flaviostutz/skylight-uas/media/suav_back.jpg

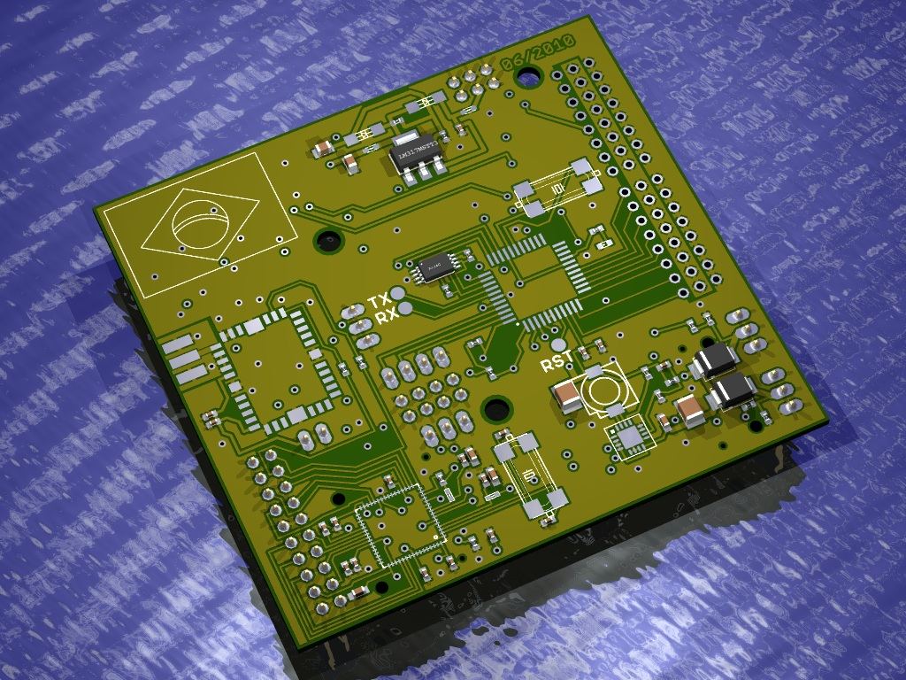
media/suav_back.jpg
