flaviostutz/skylight-uas/media/suav_front2.jpg

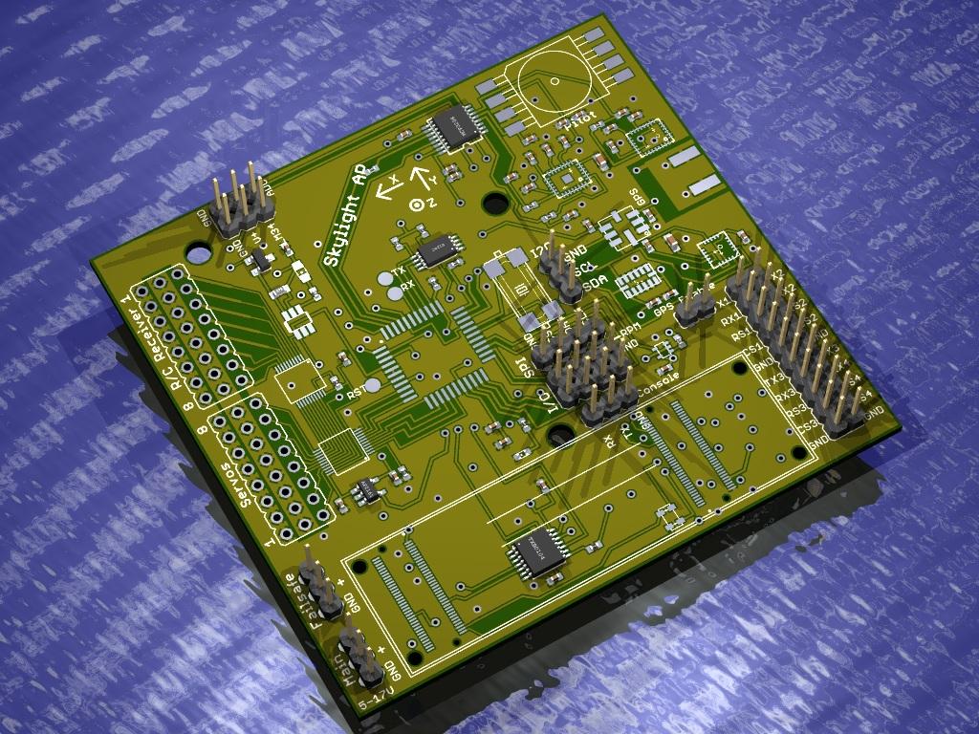
media/suav_front2.jpg
