flaviostutz/skylight-uas/src/skylight-autopilot-simulation/bin/br/skylight/flightsim/cessnamodel/FIN1.JPG

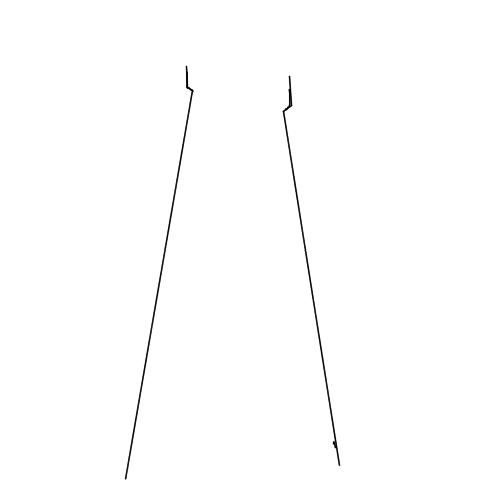
src/skylight-autopilot-simulation/bin/br/skylight/flightsim/cessnamodel/FIN1.JPG
