flaviostutz/skylight-uas/src/skylight-autopilot-simulation/bin/br/skylight/flightsim/cessnamodel/FUS.JPG

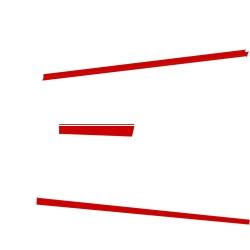
src/skylight-autopilot-simulation/bin/br/skylight/flightsim/cessnamodel/FUS.JPG
