flaviostutz/skylight-uas/src/skylight-autopilot-simulation/bin/br/skylight/flightsim/cessnamodel/WING1.JPG

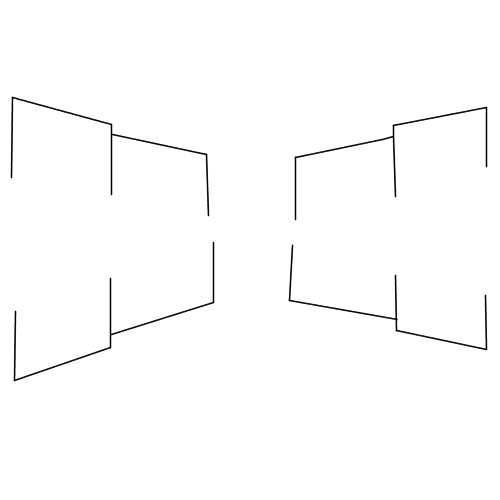
src/skylight-autopilot-simulation/bin/br/skylight/flightsim/cessnamodel/WING1.JPG
