flaviostutz/skylight-uas/src/skylight-cucs/files/Planning.xlsx

Sheet: Overall
Item | Who | Phase | Anotações | Model | Budget (US$)
Video system
Camera |  | Ready to use | Consertar problema de mal contato | Sony FCBEX78BP
2.4GHz omni antenna |  | Ready to use |  | Blackwidow
2.4GHz video transmitter |  | Ready to use |  | Blackwidow | $229.00 | http://www.blackwidowav.com/bwav2401000components.html
2.4GHz patch antenna |  | Ready to use
2.4GHz video receiver |  | Ready to use |  | Blackwidow
Antenna gimbal PT |  | Not planned
Antenna tracking system |  | Not planned | Create PWM signals from serial commands about desired pan/tilt
A/V capture card |  | Ready to use
Camera PTZ system |  | Ready to build | Create PWM signals from serial commands about desired pan/tilt
Camera gimbal PT |  | Ready to build | Testes de vibração, drag etc
Data link system
900MHz Omni antenna 1 |  | Ready to use |  | Aerocomm 4790 kit
900MHz Transceiver 1 |  | Ready to build | Colocar em uma caixa | Aerocomm 4790 kit
900MHz Omni antenna 2 |  | Ready to use |  | Aerocomm 4790 kit
900MHz Transceiver 2 |  | Ready to build | Adaptar ao sistema do avião (conector, alimentação etc) | Aerocomm 4790 kit
Ground Station
Skylight Ground Station |  | Building | Antenna tracking interface, video recording, video assisted mode, bottle drop control Camera control: manual PTZ control, auto track point commands, camera settings (day/night mode, EV level, focus mode)
Video recording software |  | Ready to build
Autopilot system
Skylight autopilot |  | Building | Camera control (IR stabilization, track point, manual commands from ground - PTZ) Bottle launch, manual termination, log storage
Onboard OS |  | Ready to build | Linux distribution, OpenSDK Java 1.6, 1 serial port, 2 USB ports for serial comm, sd card boot/storage
Onboard computer |  | Ready to build | Ajustar montagem em caixa adequada, teste de vibração, interferências, estabilidade de temperatura, montagem da alimentação, conectores de comunicação (serial, USB) | Via PX5000EG | $259.95 | http://www.e-itx.com/via-epia-px5000eg.html
Sensors
GPS |  | Ready to build
Termopiles |  | Ready to use
Pressure sensor |  | Ready to build
Sonar |  | Not planned | Somente com decolagem autônoma
RPM sensor |  | Ready to build
Emergency terminator
Watchdog |  | Ready to build
Parachute launcher |  | Not planned | Ver construção final do lançador
Engine kill system |  | Ready to build
Misc
Bottle launcher |  | Ready to build
Main power system |  | Ready to build
Backup power system |  | Ready to build
Actuators servos |  | Ready to use
2 X USB serial cable (UAV) |  | Ready to use
2 X USB serial cable (Ground) |  | Not planned
2 X optical cable (UAV) |  | Ready to use
SD Micro card 1 GB |  | Planned

Sheet: Tasks software
Criar view de monitoração/configuração de ADT e GDT |  | 2 | Ready to build | X | Marco 6: Validação do sistema de terminação de vôo | Sistemas de terminação prontos e testados
Adaptar Skylight Autopilot para JSE |  | 2 | Ready to use | X
Criar gateway para AC4790 no piloto automático |  | 2 | Ready to build | X | Marco 5: Vôo com vídeo estabilizado | Validação da eficácia do sistema em campo
Criar gateway para AC4790 no VSM | Testar comandos proprietários do modem como leitura de tabela RSSI etc | 2 | Ready to build | X
Escolher distribuição de Linux |  | 2 | Planned | X
Fazer adaptador USB-Serial funcionar no Linux |  | 2 | Planned | X | Marco 2: Simulação com hardware-in-the-loop | Validação do hardware e software montados
Fazer testes de hardware in the loop | Pendente dos itens da fase 2 | 2 | On analysis | X | Marco 3: Vôo com piloto automático no hardware/software novos | Validar plataforma em campo e ajustar piloto automático para um nível de confiabilidade alto
Fazer testes do throttle |  | 2 | Ready to build | X
Montar distribuição linux bootável pronta | Falta verificar | 2 | Ready to build | X
Testar piloto automático no Linux |  | 2 | On analysis | X
Implementar view de controle de waypoint |  | 2 | Ready to build | X
Validar controle de waypoint em simulador |  | 2 | Planned | X
Validar controle de loiter em simulador |  | 2 | Planned | X
Criar view de manutenção de missão | Waypoints, routes, safety actions, boundaries, home, etc | 2 | Ready to build | X
Validar controle de missão no simulador |  | 2 | Planned | X
Fazer failover no piloto automático para perda de sinal de GPS/link principal | Desenhar estratégias de fail-over | 3 | Ready to build |  | Marco 7: Missão de busca simulada em campo | Validação de plataforma e procedimentos da missão adotados
Melhorar logs da caixa preta | Colocar logs de comandos manuais e fases da missão | 3 | Ready to build |  | Marco 4: Vôo com piloto automático + vídeo | Verificar funcionamento correto da plataforma com vídeo ativado e qualidade do sinal
Alterar gateway de atuadores para incluir comandos PTZ da camera |  | 4 | Ready to build
Configurações da camera | day/night mode, EV level, focus mode | 4 | Ready to build
Controle PTZ da camera | Controle de pan/tilt/zoom com joystick. O piloto automático corrigirá o gimbal de acordo com a atitude do avião. | 4 | Ready to build
Criar gateway para camera para enviar comandos de configuração e zoom |  | 4 | Ready to build
Enviar comandos do ground station para a câmera | Levar em conta a estabilização de acordo com atitude | 4 | Ready to build
Fazer mudança nas mensagens com UAV para incluir comandos/configurações relacionadas à imageria | Verificar itens de imageria | 4 | Ready to build
Gravador de vídeo | Placa de captura | 4 | Ready to build
Snapshot do vídeo a partir do joystick | Histórico georeferenciado de fotos, com opção de loiter e apontamento de tracking da camera. As fotos aparecem como landmarks no mapa do ground station, que podem ser clicados para apresentação da foto e comandos de loiter na posição. Emitir som ao realizar snapshot | 4 | Ready to build
Tela de controle da câmera | Configurações e comandos da câmera/PTZ, registro de fotos e comandos no UAV relacionados à busca (loiter, tracking, pause/resume mission etc) | 4 | Ready to build
Vídeo com overlay de infos sobre vôo | Tempo de vôo, velocidade, altitude, pitch, roll e mapa do terreno | 4 | Ready to build
Estabilização automática da câmera de acordo com atitude do avião | Ground station pode ligar/desligar função. O usuário envia comandos de PT de acordo com um referencial plano da camera e o piloto automatico faz correções na camera de acordo com a atitude do avião | 5 | Ready to build
Estabilização digital automática da imagem considerando vibrações indesejadas da câmera/uav |  | 5 | Ready to build
Implementar tracking da camera para um ponto | Usuário clica em ponto do mapa e manda a camera manter o ponto na mira. Ajustes de baixa frequencia são realizados via feedback de análise de imagem | 5 | On analysis
Controle de lançamento da garrafa | Criar aba "payload" para lançamento manual da garrafa | 7 | Ready to build
Vídeo com overlay de shapes identificados automaticamente | Formas com certa luminosidade, proporção e tamanho (com erros associados) são marcadas em overlay no vídeo. Quando a forma é identificada, há opção de tirar um snapshot automático do vídeo, fazer loiter ou tracking automático. | 7 | On analysis
Tarefa |  | Marco | Status | Atual
Ground Station |  |  |  |  | Marcos | Objetivos | Status
Piloto Automático
 |  |  |  |  | Marco 1: Validação do hardware adquirido | Verificar se o hardware atende aos requisitos da plataforma

Sheet: Linux box
Drivers
2 usb serial cables (Prolific) | Linux kernel 2.4.31 | "modprobe pl2303"
1 usb serial cable | Linux kernel 2.6.x | "modprobe "
1 usb bluetooth (Cambridge)
