flaviostutz/skylight-uas/media/mine/gimbal.obj

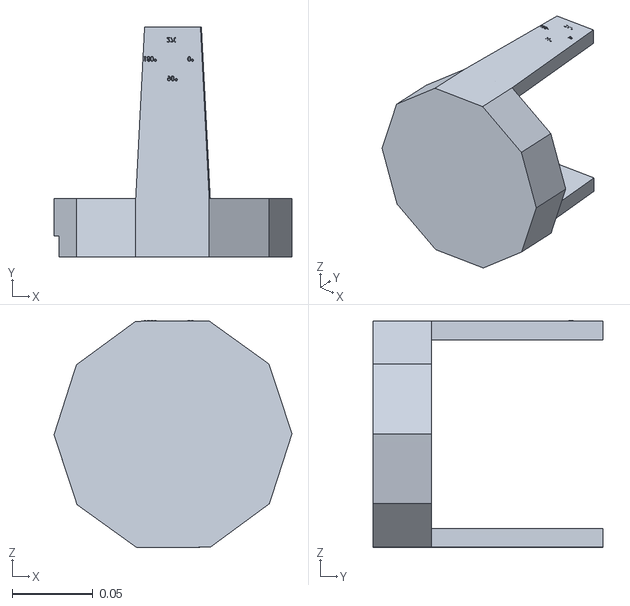
[picture p27: CAD file, 2016-09-08]
media/mine/gimbal.obj
0.148 x 0.143 x 0.141
