flaviostutz/skylight-uas/media/prepared models/Cessna001a.obj

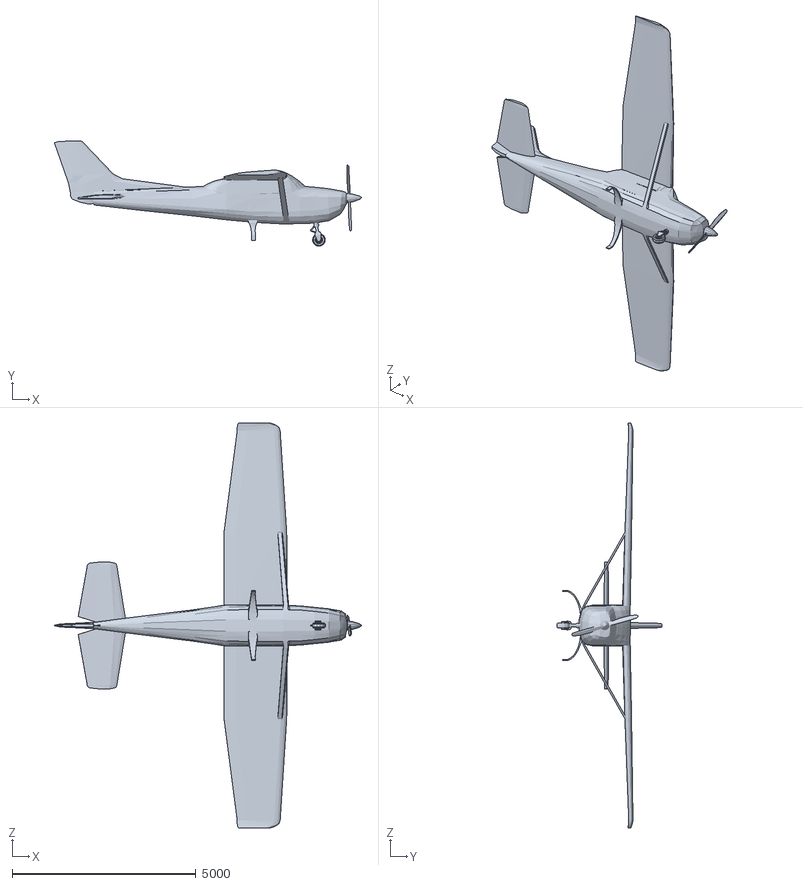
[picture p28: CAD file, 2016-09-08]
media/prepared models/Cessna001a.obj
8370.2 x 2870.5 x 11023.6
