flaviostutz/skylight-uas/media/mine/camera.obj

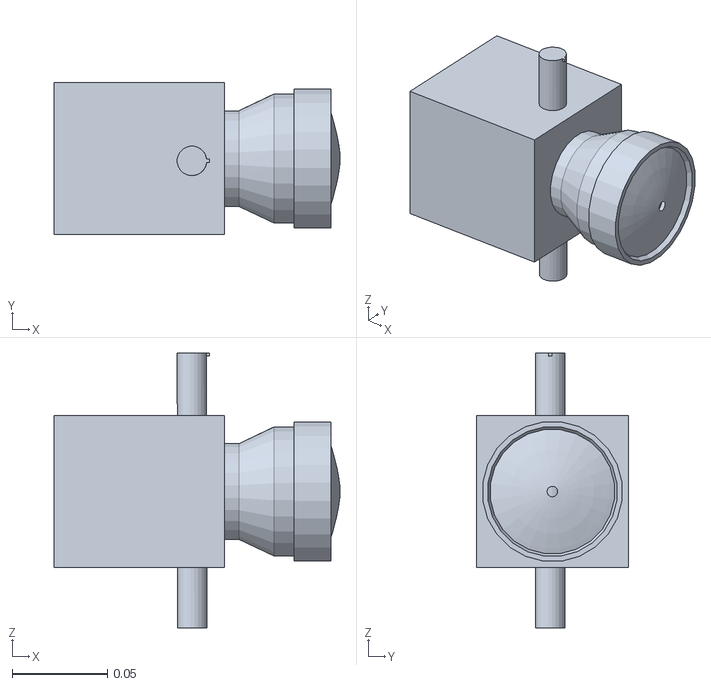
[picture p29: CAD file, 2016-09-08]
media/mine/camera.obj
0.15 x 0.0798 x 0.144
