flaviostutz/skylight-uas/media/prepared models/Cessna 001.obj

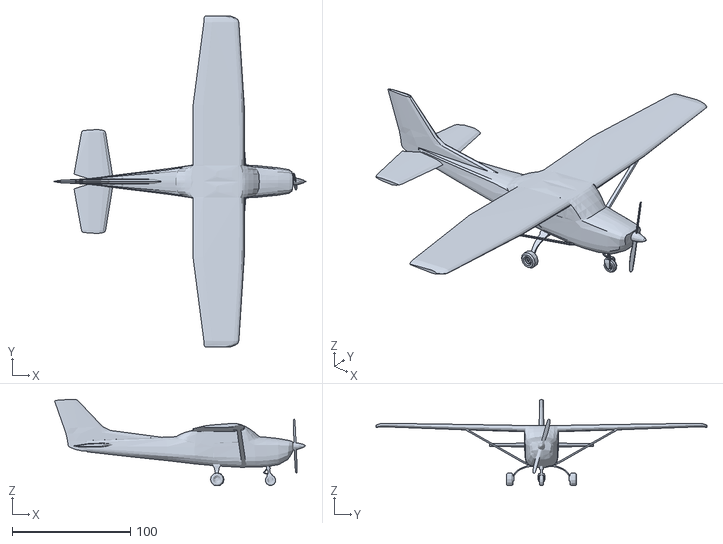
[picture p30: CAD file, 2016-09-08]
media/prepared models/Cessna 001.obj
212.6 x 280.0 x 73.0
