flaviostutz/skylight-uas/media/prepared models/glider.obj

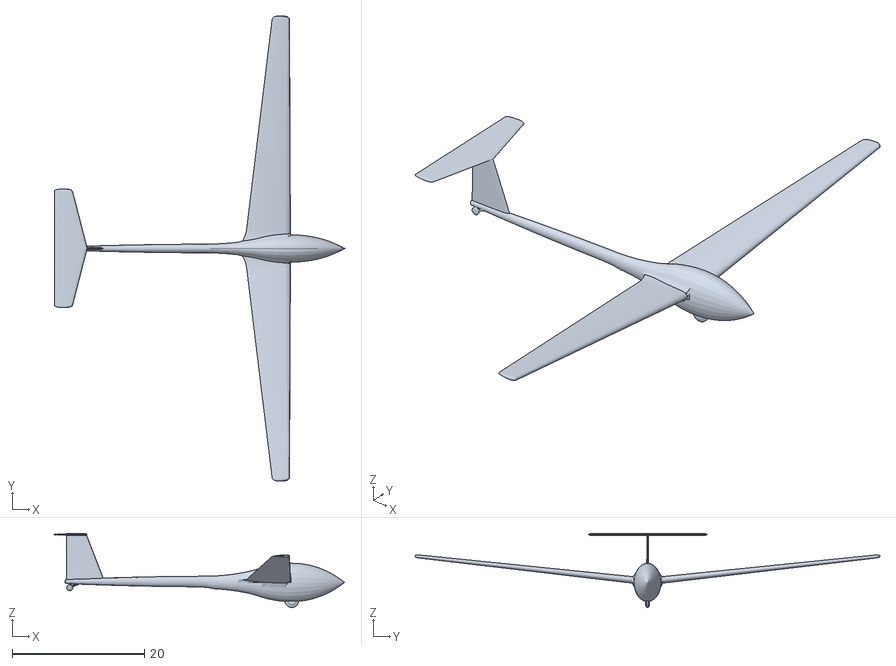
[picture p31: CAD file, 2016-09-08]
media/prepared models/glider.obj
43.9 x 70.3 x 11.2
