flaviostutz/skylight-uas/(list of files, cad)

Other CAD files:
media/prepared models/Cessna001b.obj
media/mine/camera-gimbal.skp
media/prepared models/Cessna 001.skp
media/prepared models/glider.skp
