flaviostutz/skylight-uas/annotations/Skylight-PID Instructions.txt

=== INITIAL SETUP INSTRUCTIONS ===

PIDs calibration

Rudder/aileron surface gains

> Hold yaw with rudder
  - Too much gain causes sideslips
  - Depending on gain, the calculated versus real turn will change
