flaviostutz/skylight-uas/(notices)

Notices in the files:
src/skylight-commons-ui/src/main/resources/br/skylight/commons/j3d/models/Cessna001.obj:
Copyright (C) 2006 jim.foltz@gmail.com
